slu4coder/SST39SF010-FLASH-Programmer/Legacy/AT28C64-EEPROM-Programmer/Schematic_AT28C64_Programmer.pdf

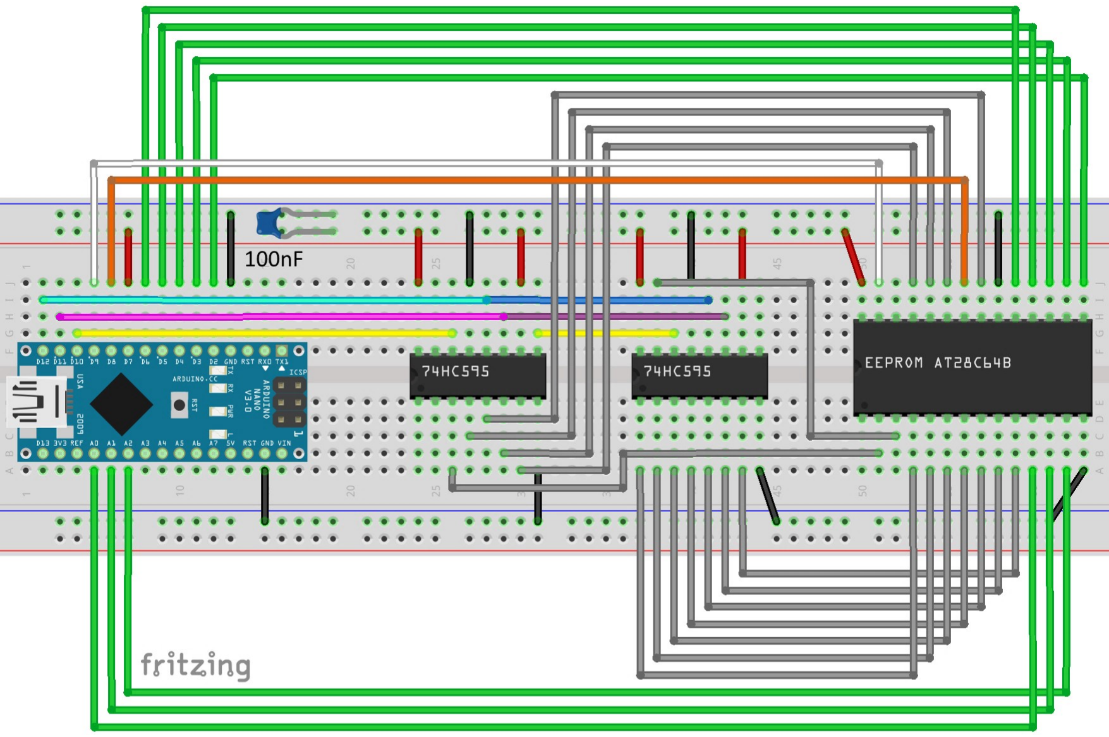
[picture p1: page 1]
