slu4coder/SST39SF010-FLASH-Programmer/Schematic_SST39SF0x0_Programmer_1.1_KiCAD.pdf

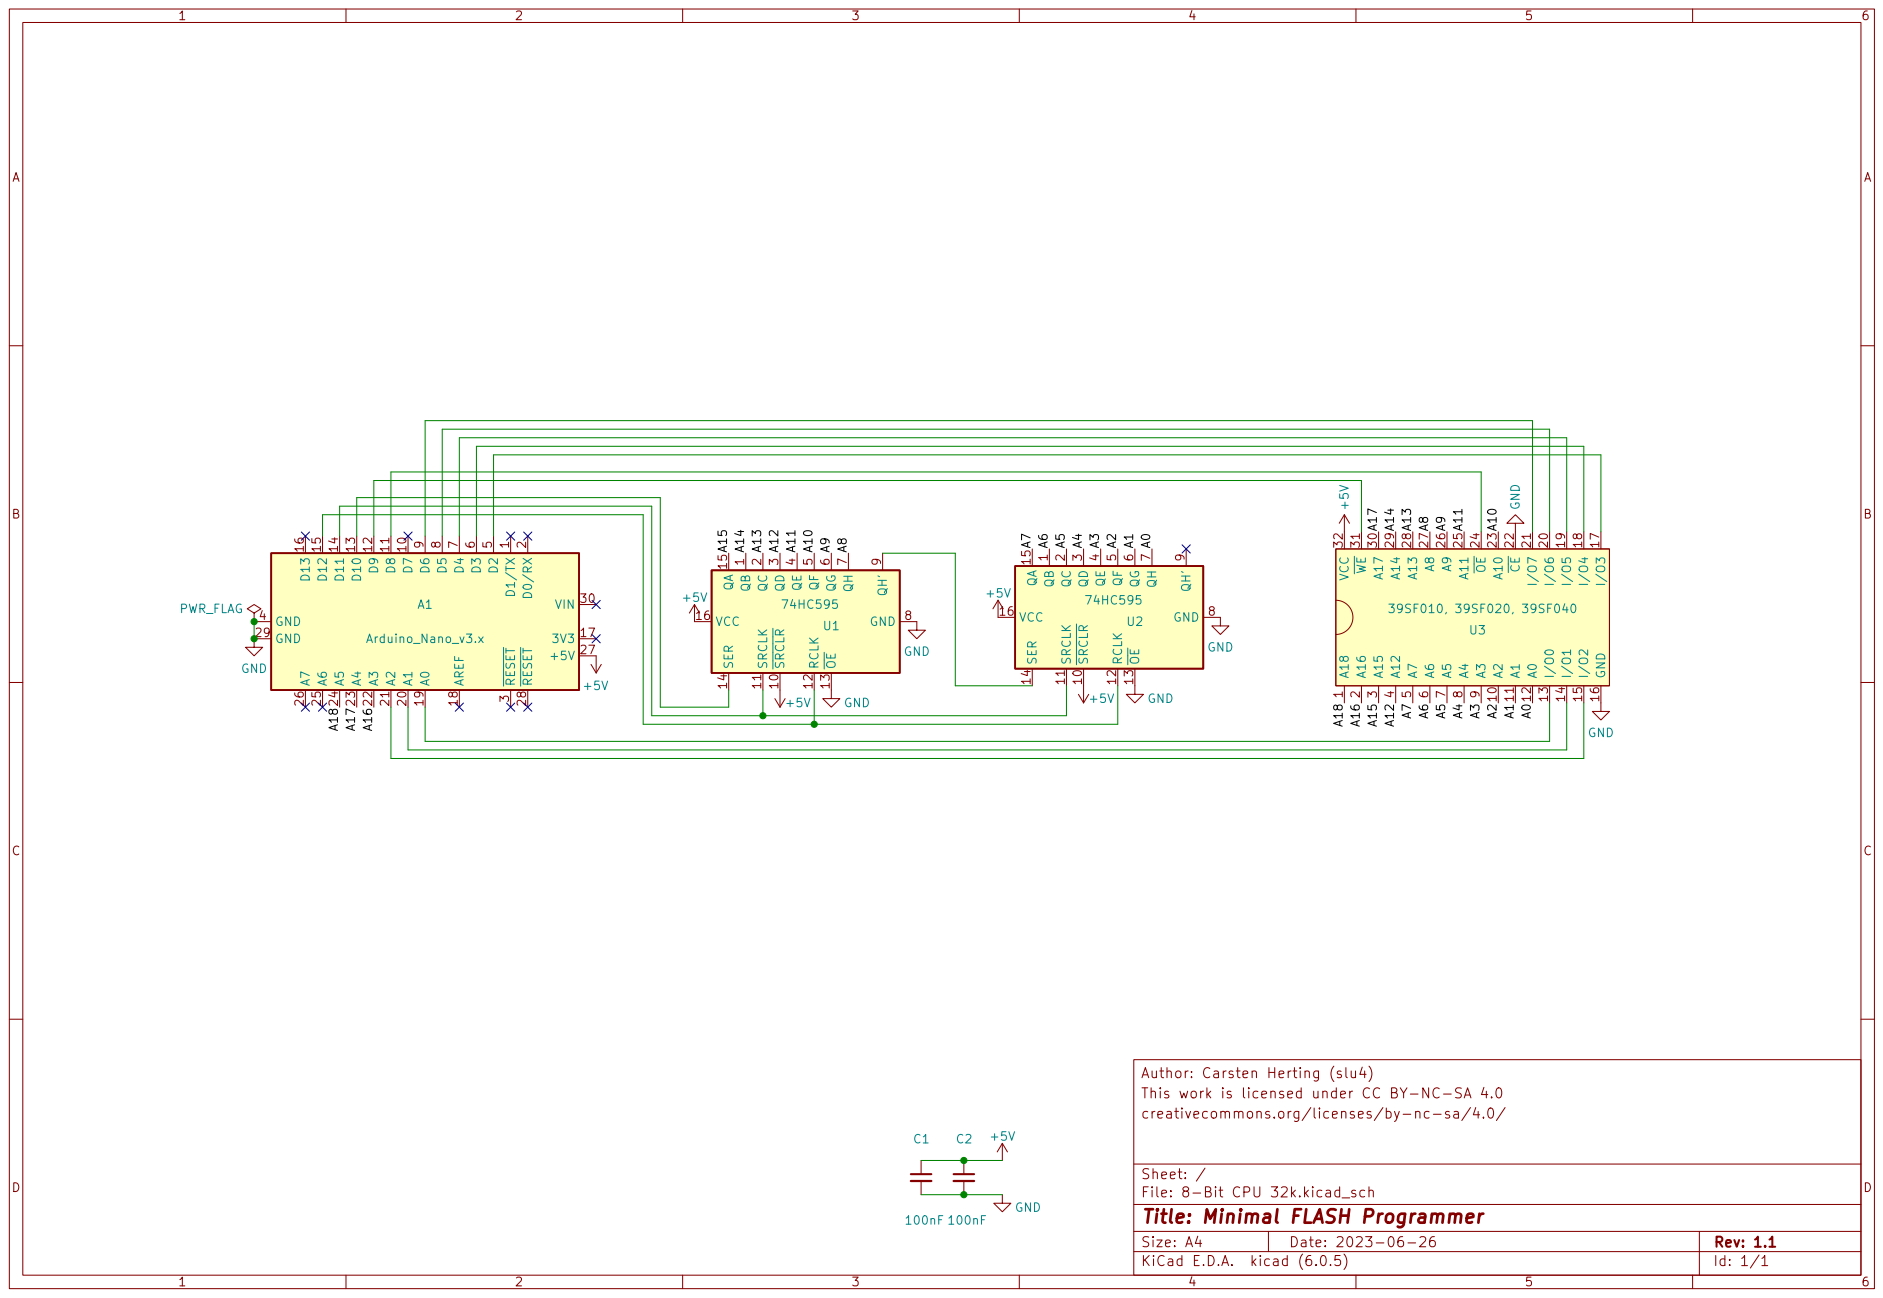
[picture p2: page 1]

2 A1 20 A2 21 A3 22 A4 23 A5 24 A6 25 A7 26 +5V 27 ~{RESET} 28 GND 29 ~{RESET} 3 VIN 30 GND 4 D2

1 ~{SRCLR} 10 SRCLK 11 RCLK 12 ~{OE} 13 SER 14 QA 15 VCC 16 QC

Id: 1/1 Title: Minimal FLASH Programmer
