slu4coder/SST39SF010-FLASH-Programmer/Schematic_SST39SF0x0_Programmer_1.1.pdf

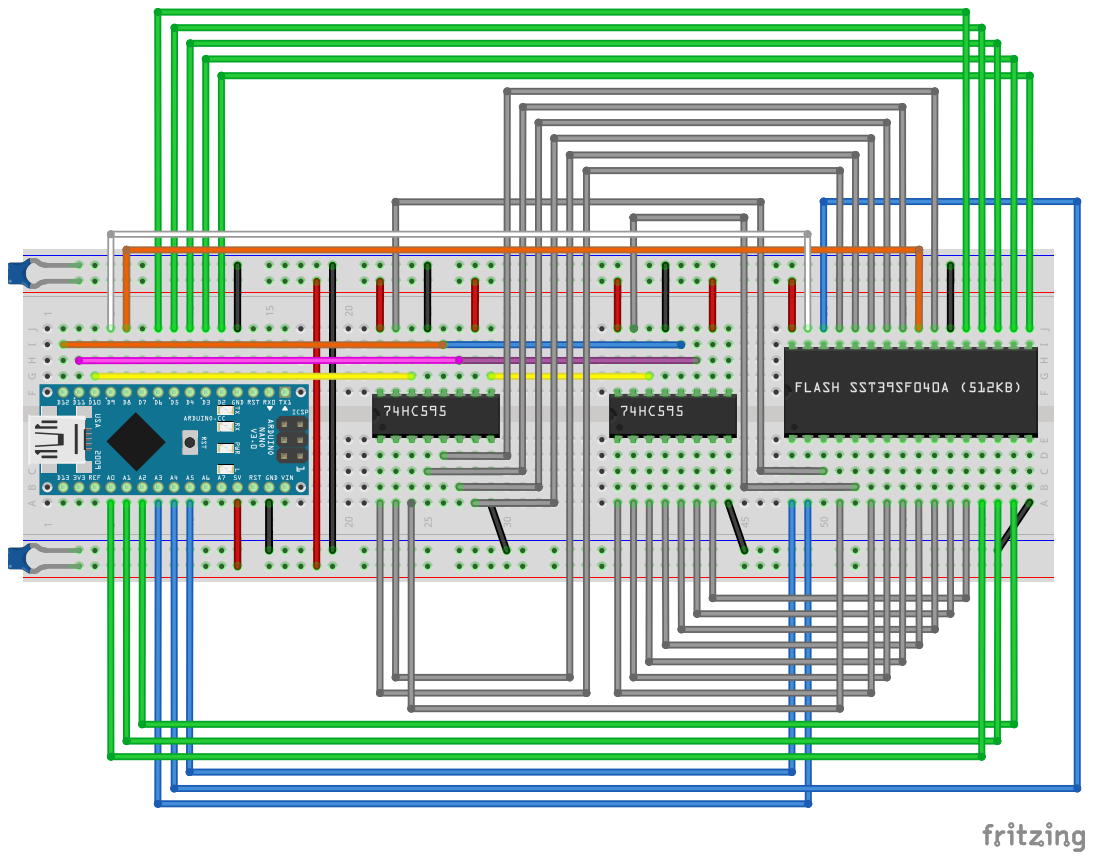
[picture p3: page 1]
