slu4coder/SST39SF010-FLASH-Programmer/(threads)

Thread 2 (2023-07-26):

EraseFLASH polling and response

Kitsuinox, 2023-07-26:
In the EraseFLASH function of the Arduino_SST39SF0x0.ini file, the timeout needs to be a lot larger for some devices such as the MX 29F002NTPC I have. There is also no response from the Arduino in case of a timeout which causes the C++ interface to get stuck in a loop waiting for the handshake. I fixed the issue by appending the else statement body with a "Serial.write('X')" which the CLI accepts as an error message. I can add the modified file in the attachments if you'd like.

Also, I love the project - you really saved my 🍑 from having to buy an EEPROM programmer (which costs a LOT here). Thanks a lot!

Closed 2025-07-18.
