slu4coder/SST39SF010-FLASH-Programmer/(commit log)

2023-06-28 PCB Version 2,0
2023-06-28 PCB Version
